KingsStarDV/FABR/CAD/Images/Screenshot 2026-10-20 090226.png

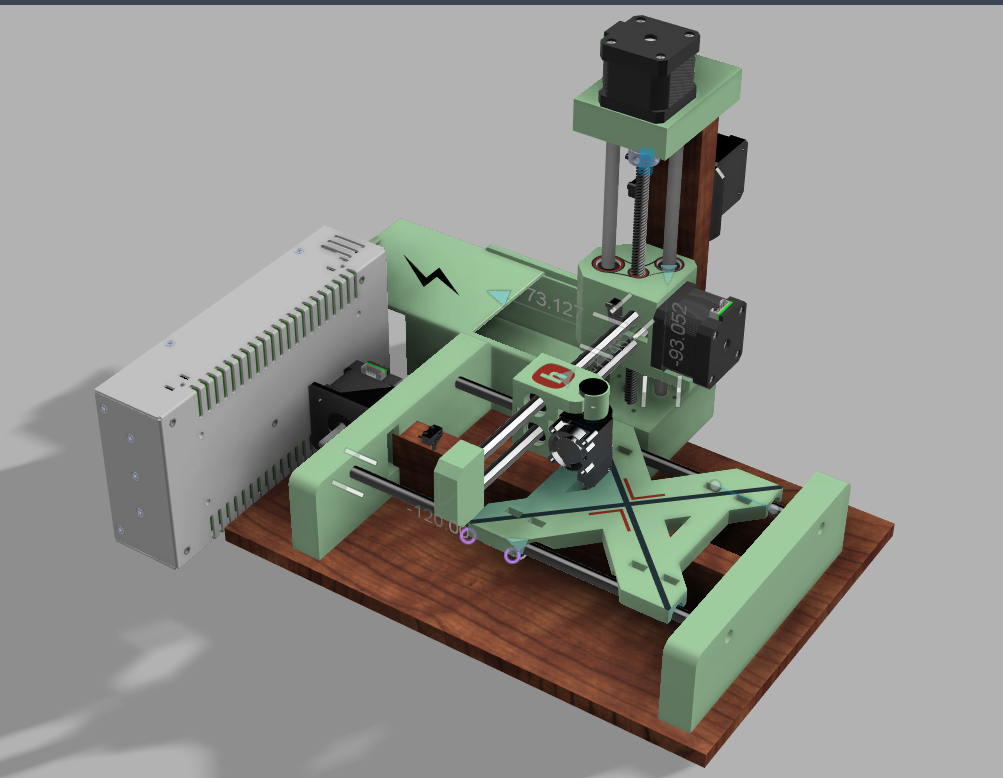
CAD/Images/Screenshot 2026-10-20 090226.png
