KingsStarDV/FABR/ASSET/Raspberry Pi pico/pico-2_view1.jpg

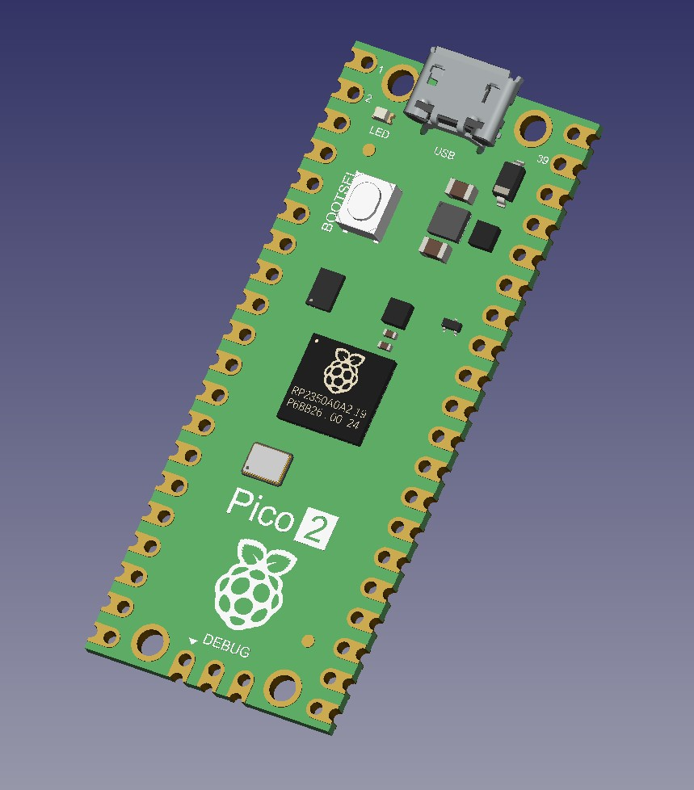
ASSET/Raspberry Pi pico/pico-2_view1.jpg
