KingsStarDV/FABR/ASSET/5mm to 8 mm coupler/[7862] Aluminum Flexible Coupling Coupler Helical Shaft 5mm x 8mm sunrobotics_in.JPG

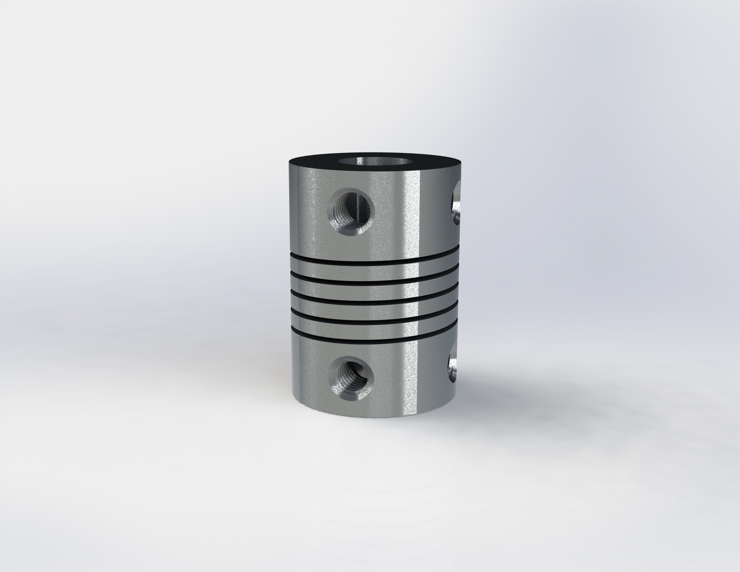
ASSET/5mm to 8 mm coupler/[7862] Aluminum Flexible Coupling Coupler Helical Shaft 5mm x 8mm sunrobotics_in.JPG
