KingsStarDV/FABR/ASSET/8mm lead screw/screw.PNG

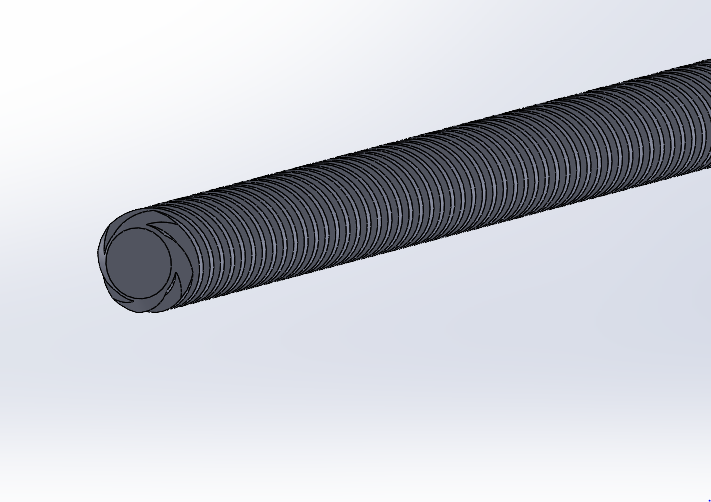
ASSET/8mm lead screw/screw.PNG
