KingsStarDV/FABR/ASSET/8mm_Linear Bearing/linear Bearing 2.png

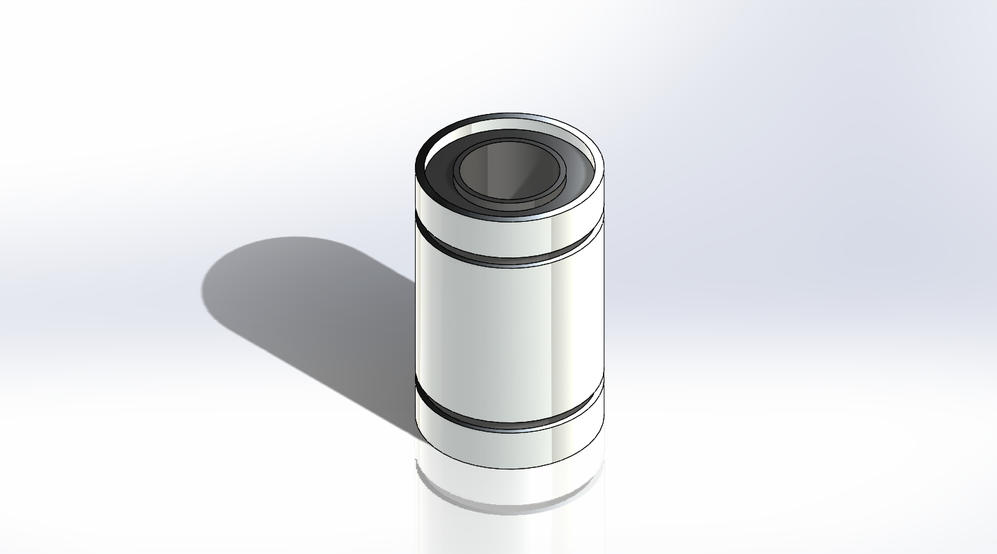
ASSET/8mm_Linear Bearing/linear Bearing 2.png
