KingsStarDV/FABR/ASSET/8mm_Linear Bearing/linear Bearing.png

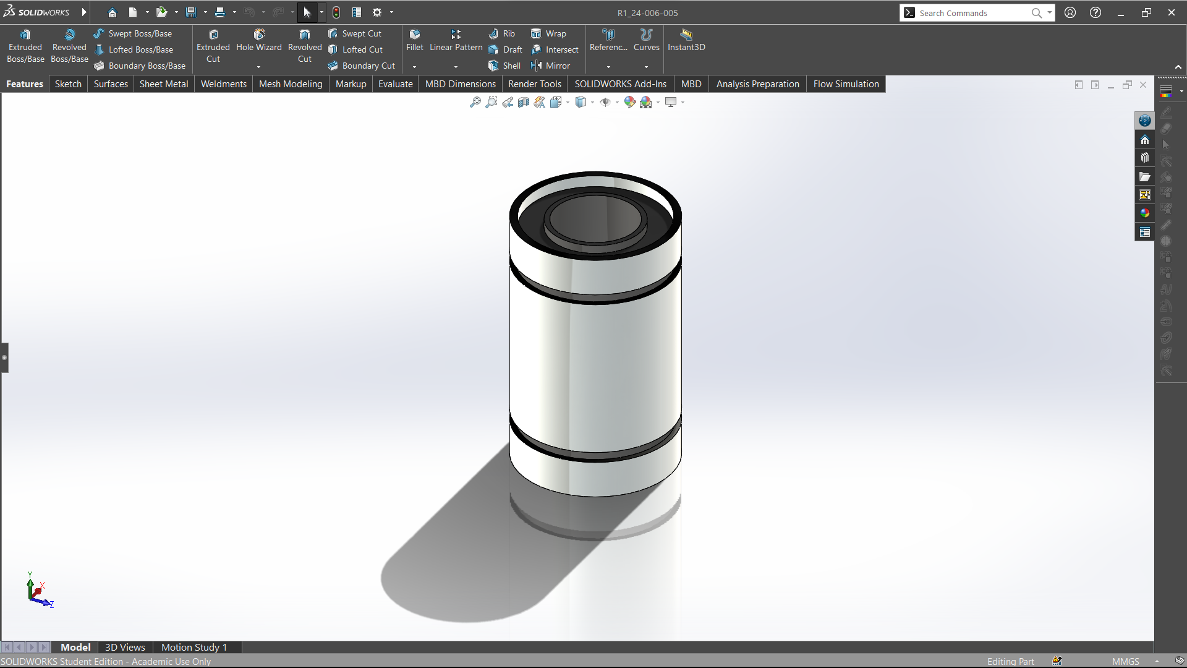
ASSET/8mm_Linear Bearing/linear Bearing.png
