KingsStarDV/FABR/ASSET/Bowden Extruder/Bowden accessory2.png

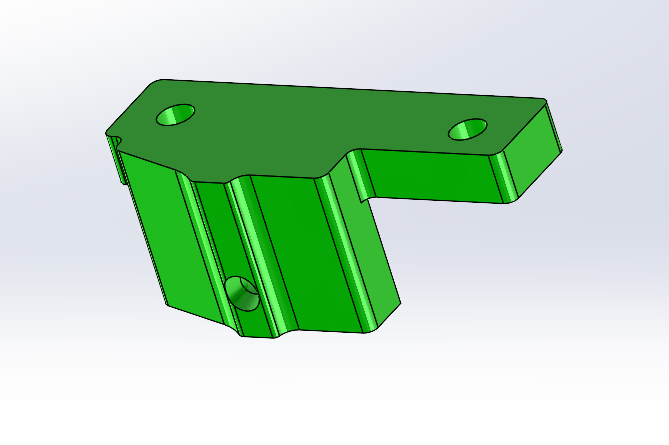
ASSET/Bowden Extruder/Bowden accessory2.png
