KingsStarDV/FABR/ASSET/Bowden Extruder/Bowden accessory3.png

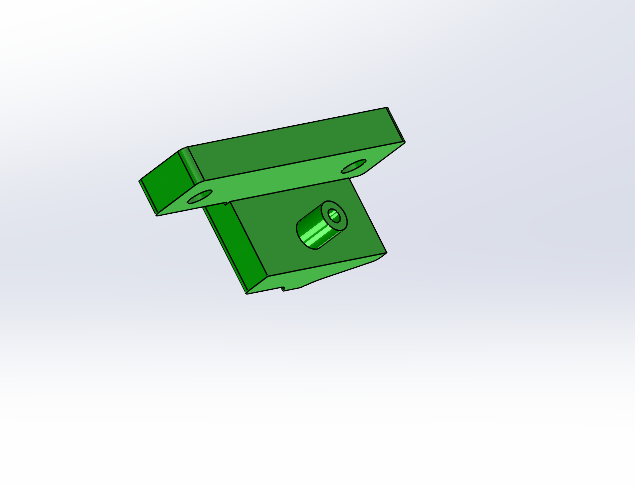
ASSET/Bowden Extruder/Bowden accessory3.png
