KingsStarDV/FABR/ASSET/Bowden Extruder/Bowden accessory.png

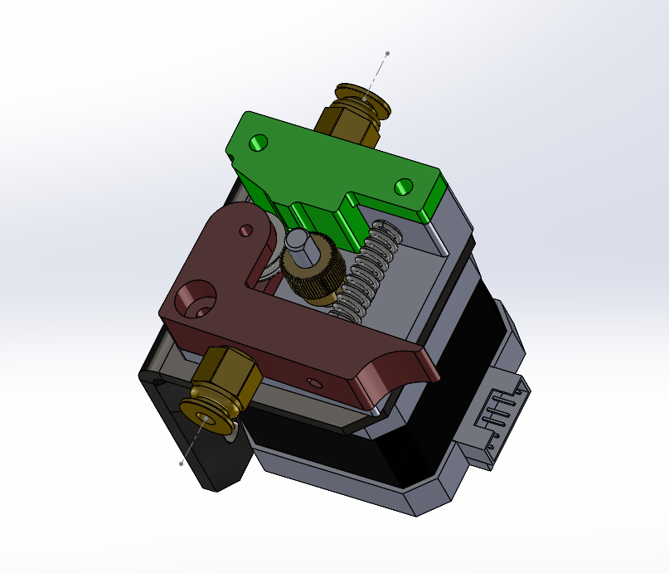
ASSET/Bowden Extruder/Bowden accessory.png
