KingsStarDV/FABR/ASSET/Lead Screw NUT/IMG_7766.jpeg

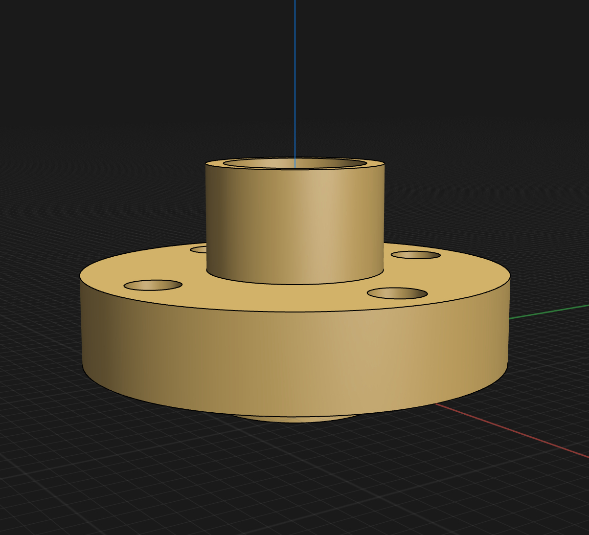
ASSET/Lead Screw NUT/IMG_7766.jpeg
