KingsStarDV/FABR/ASSET/Lead Screw NUT/IMG_7767.jpeg

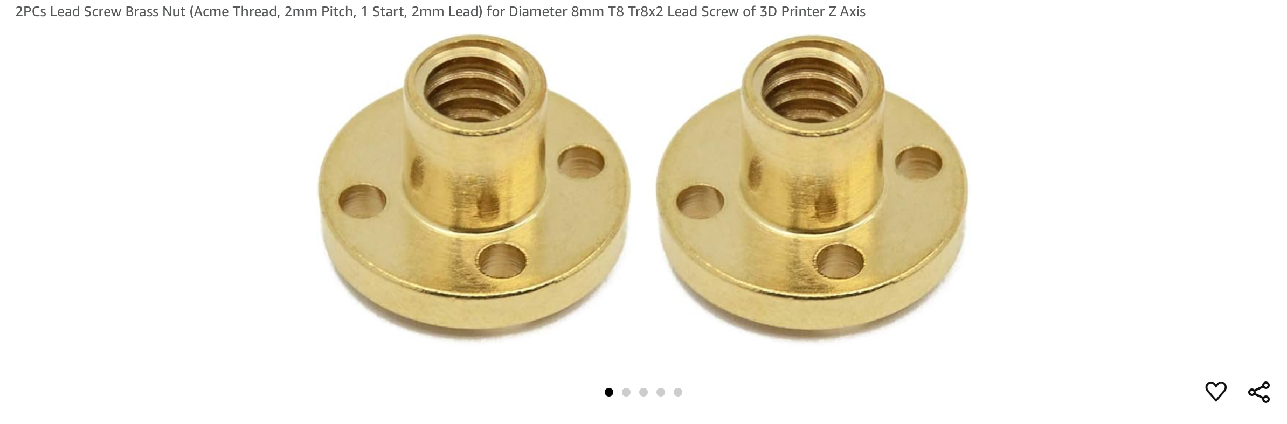
ASSET/Lead Screw NUT/IMG_7767.jpeg
