KingsStarDV/FABR/ASSET/Limit_Switch_L1/Capture.png

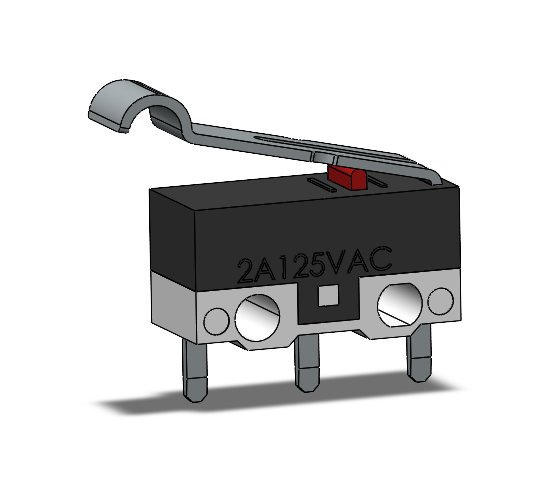
ASSET/Limit_Switch_L1/Capture.png
