KingsStarDV/FABR/ASSET/Raspberry Pi pico/pico-2_view2.jpg

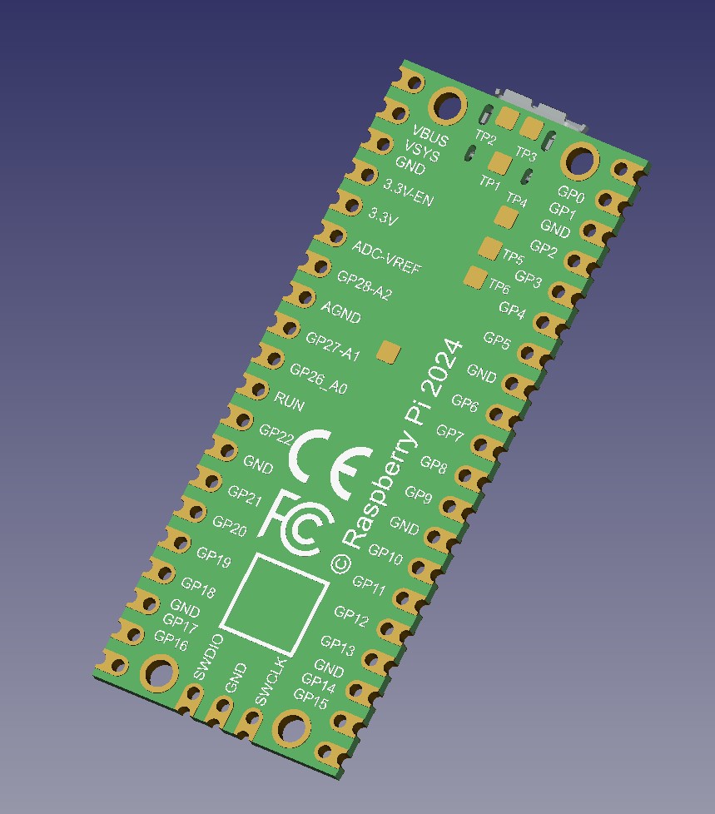
ASSET/Raspberry Pi pico/pico-2_view2.jpg
