KingsStarDV/FABR/ASSET/Raspberry Pi pico/pico-2_view3.jpg

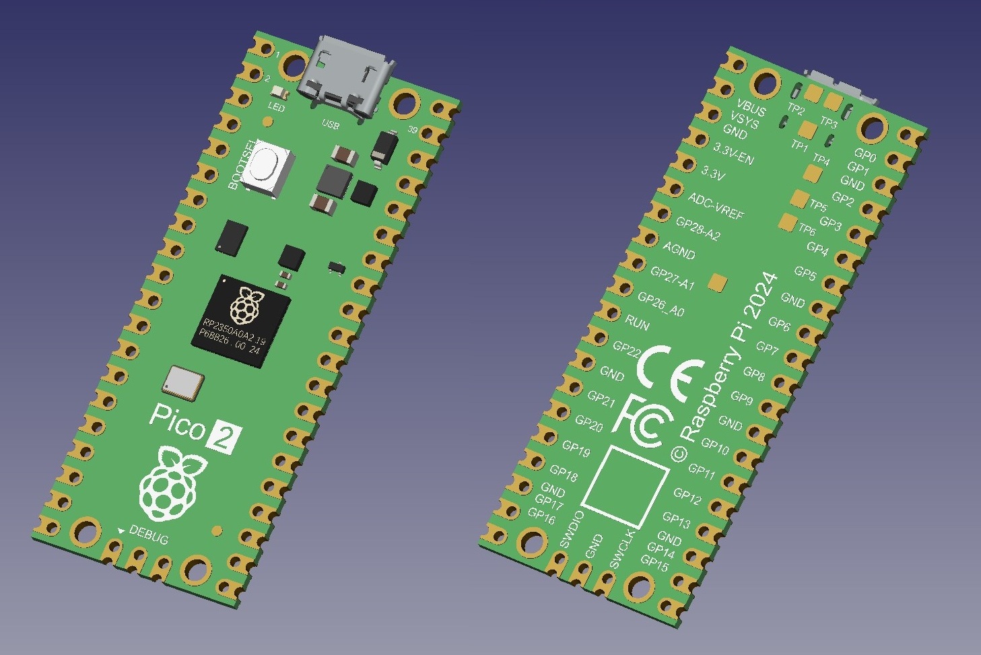
ASSET/Raspberry Pi pico/pico-2_view3.jpg
