KingsStarDV/FABR/ASSET/Raspberry Pi pico/raspberry_pico_size.png

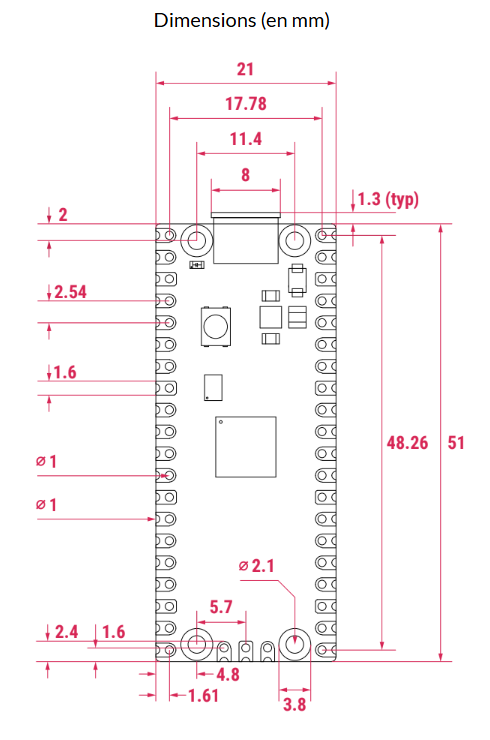
ASSET/Raspberry Pi pico/raspberry_pico_size.png
