KingsStarDV/FABR/ASSET/V6J Hotend/Hotend Volcano J-head V6.PNG

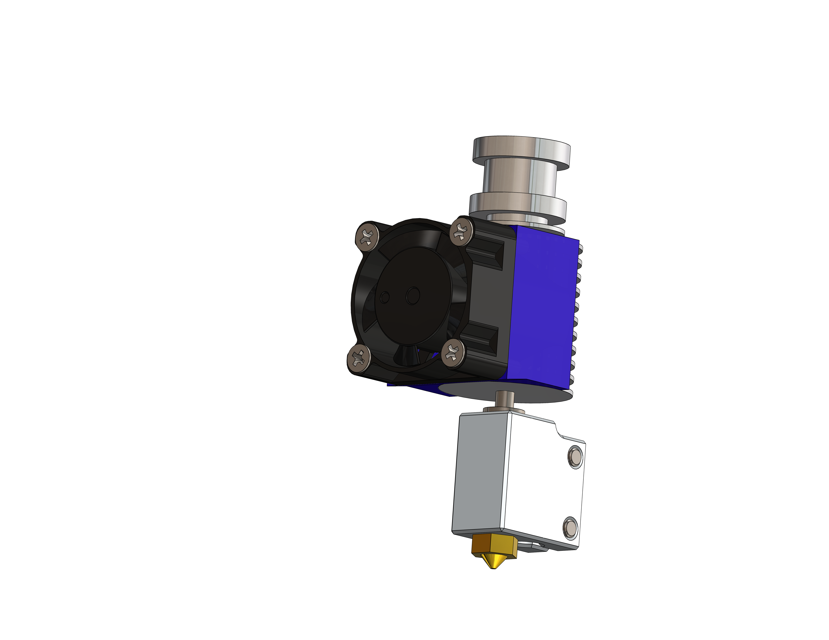
ASSET/V6J Hotend/Hotend Volcano J-head V6.PNG
