KingsStarDV/FABR/Images/325ba0f1-53e9-48e7-aa71-8d3992a2570e.PNG

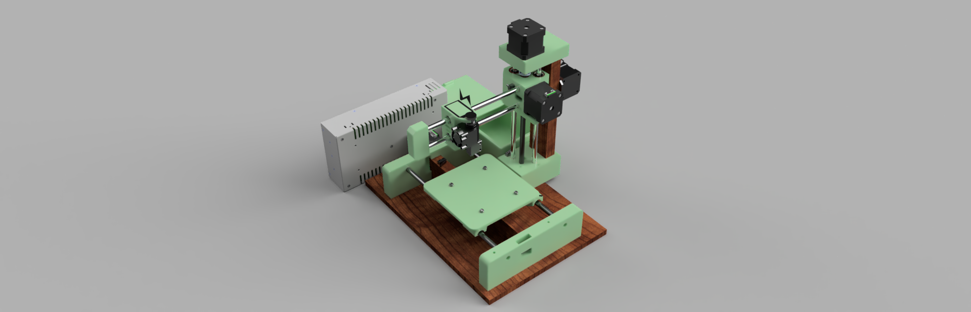
Images/325ba0f1-53e9-48e7-aa71-8d3992a2570e.PNG
