KingsStarDV/FABR/Images/WD1.png

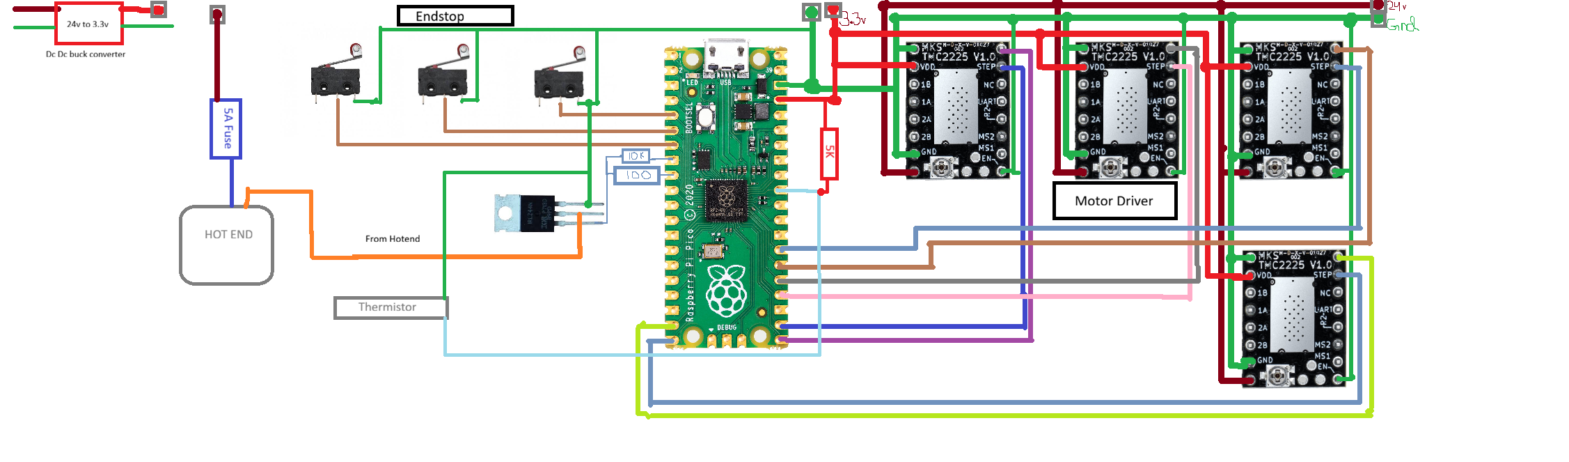
Images/WD1.png
