KingsStarDV/FABR/BOM.csv

Item | Qty | Description | Unit Price ( INR ) | Total Price( INR ) | Total Price (USD) | Link
Raspberry Pi Pico | 1 | Microcontroller | 384 | 384 | 4.608 | https://robu.in/product/raspberry-pi-pico/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
TMC2225 | 4 | Stepper Motor Driver | 400 | 1600 | 19.2 | https://robu.in/product/bigtreetech-tmc2225-v1-0-stepper-motor-driver/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
Nema 17 Motor | 4 | Stepper Motor | 549 | 2196 | 26.352 | https://robocraze.com/products/17hs4401-nema17-stepper-motor-40mm?variant=42490709246176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
Endstop Switch | 3 | Switches for Homing | 23 | 69 | 0.828 | https://robu.in/product/kw4-z5f150-spdt-roller-lever-micro-switch-5a1-5n/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
Irfz44N | 1 | Mosfet for Hotend | 44 | 44 | 0.528 | https://robu.in/product/irlz44n/
V6 J hotend | 1 | hotend | 764 | 764 | 8.404 | https://evelta.com/v6-remote-hotend-with-fan-24v-40w-1-75-0-4mm/?sku=509-B01487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
DC-DC buck converter | 1 | To change 24v to 3.3v for electronic | 135 | 135 | 1.62 | https://robocraze.com/products/lm2596-dc-dc-step-down-buck-module-with-display?_pos=2&_sid=0c32e3ade&_ss=r
4.7K resistor | 8 | Got 8 as they were the MOQ/ replacement as the 5K resistors | 1.3 | 11 | 0.132 | https://robu.in/product/4-7k-ohm-1w-metal-film-resistor-pack-of-40/
100ohm Resistors | 6 | 6 is the MOQ | 1.7 | 11 | 0.132 | https://robu.in/product/1w-100-ohm-resistor-pack-of-40/
5A Fuse | 2 | 2 is MOQ | 9 | 18 | 0.216 | https://robu.in/product/1-month-warranty-1350/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
Smooth Rod (1 meter) | 1 | total length required: 1380mm Will get the part in (1 + 0.4) m | 380 | 380 | 4.56 | https://onlyscrews.in/products/8mm-smooth-rod-stainless-steel-304-1meter-1000mm
Smooth Rod (0.4m) | 1 | --------- | 179 | 179 | 2.148 | https://robu.in/product/400-mm-long-chrome-plated-smooth-rod-diameter-8-mm/
LM8UU | 10 | Linear bearing (8mm) | 49 | 490 | 5.88 | https://robocraze.com/products/lm8uu-8-mm-linear-motion-bearing-for-3d-printer?variant=40193531052185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
MK8 Bowden Extruder Kit | 1 | this includes all parts required to make a extruder | 199 | 199 | 2.388 | https://robocraze.com/products/extruder-kit-left-side-mk8-aluminum-3d-printer-block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
Nema 17 Mount | 2 | mount for stepper motor | 202 | 404 | 4.848 | https://robu.in/product/easymech-bracket-for-nema-17-stepper-motor/
Lead Screw (300mm) + Nut | 1 | -----nearest i could find to 240mm is 300mm | 249 | 249 | 2.988 | https://robocraze.com/products/trapezoidal-screw-300mm-rod-with-copper-nut?_pos=5&_sid=3191a7e76&_ss=r
5mm to 8mm shaft coupler | 1 | to join lead screw and nema17 shaft | 105 | 105 | 1.26 | https://robu.in/product/nema-17-shaft-coupling-coupler-shaft-5mm-x-8mm/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
GT2 6mm pulley | 2 | ---------- | 45 | 90 | 1.08 | https://robocraze.com/products/gt2-6mm-belt-width-20-teeth-5mm-bore-timing-pulley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
GT6 6mm Timing Belt(1m) | 1 | needed:90cm | 90 | 90 | 1.08 | https://robocraze.com/products/1-meter-x-gt2-open-timing-belt-6mm-width-pitch-2mm-for-3d-printer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
Zip ties | 50 | to hold together timing belts, and fix bed plate with linear bearings | 0.4 | 20 | 0.24 | https://onlyscrews.in/products/2-5mm-x-100mm-white-color-multi-purpose-self-locking-nylon-industrial-grade-cable-zip-tie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
M4 Screws | 10 | ----- | 2.8 | 28 | 0.336 | https://onlyscrews.in/products/chhd-m4-x-20mm-pack-of-20
M1.6 Screws | 4 | -------- | 6 | 24 | 0.288 | https://onlyscrews.in/products/m1-6-x-8mm-hex-allen-socket-head-ss-304-screw-dia-1-6mm-length-8mm
M4 60mm Screw | 5 | -----For the Rod holders-- | 13 | 65 | 0.78 | https://onlyscrews.in/products/m4-x-60mm-hex-allen-csk-high-tensile10-9-black-oxide-screw-dia-4mm-length-60mm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
M3 8mm | 14 | ---for stepper motor | 1.2 | 16.8 | 0.2016 | https://onlyscrews.in/products/m3-x-6mm-phillips-csk-ss-304-screw-dia-3mm-length-6mm
M3 10mm | 4 | ----for vertical support and custom mount | 1.6 | 6.4 | 0.0768 | https://onlyscrews.in/products/phillips-csk-m3-x-10mm-pack-of-20
M2 Screws | 8 | --------- | 2.6 | 20.8 | 0.2496 | https://onlyscrews.in/products/m2-x-5mm-hex-allen-socket-head-ss-304-screw-dia-2mm-length-5mm
3.5mm Self Tapping Screw | 4 | ---for extruder and bottom y axis part. | 1.6 | 6.4 | 0.0768 | https://onlyscrews.in/products/no-63-5mm-x-13mm-phillips-csk-ss-304-self-tapping-wood-screw
Compression Spring | 4 | -----for bed assembly | 6 | 24 | 0.288 | https://onlyscrews.in/products/od-6mm-free-length-15mm-wire-dia-0-8mm-compression-spring-stainless-steel-304
M4 20mm Screw | 4 | -----for bed assembly | 3.2 | 12.8 | 0.1536 | https://onlyscrews.in/products/m4-x-20mm-hex-bolt-ss304-dia-4mm-length-20mm
M4 Hex Nut | 4 | ----for bed assembly | 1.6 | 6.4 | 0.0768 | https://onlyscrews.in/products/m4-nylon-hex-nut-dia-4mm
Wire (3m) | 3 | for connections of endstop switches and motor drivers | 45 | 135 | 2.7 | https://robocraze.com/products/ribbon-cable-10-wire-1-meter?_pos=1&_sid=4ef974617&_ss=r
4 pin JST connector | 4 | for connecting stepper motor | 50 | 200 | 2.4 | https://robu.in/product/720mm-cable-with-connector-for-nema17-stepper-motor/
24v SMPS | 1 | ----------Already have it | -- | -- | 0 | --
1 Kg PETG Filament | 1 | -------For printing legion | 1000 | 1000 | 12 | https://robocraze.com/products/anycubic-petg-black-1kg-1-75mm-petg-3d-printer-filament?variant=67651507224800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
 |  |  | Total Shipping Costs (INR) : | 149
 |  |  | Total Cost (USD): | 108.1192
