KingsStarDV/FABR/ASSET/5mm to 8 mm coupler/[7862] Aluminum Flexible Coupling Coupler Helical Shaft 5mm x 8mm sunrobotics_in.STEP

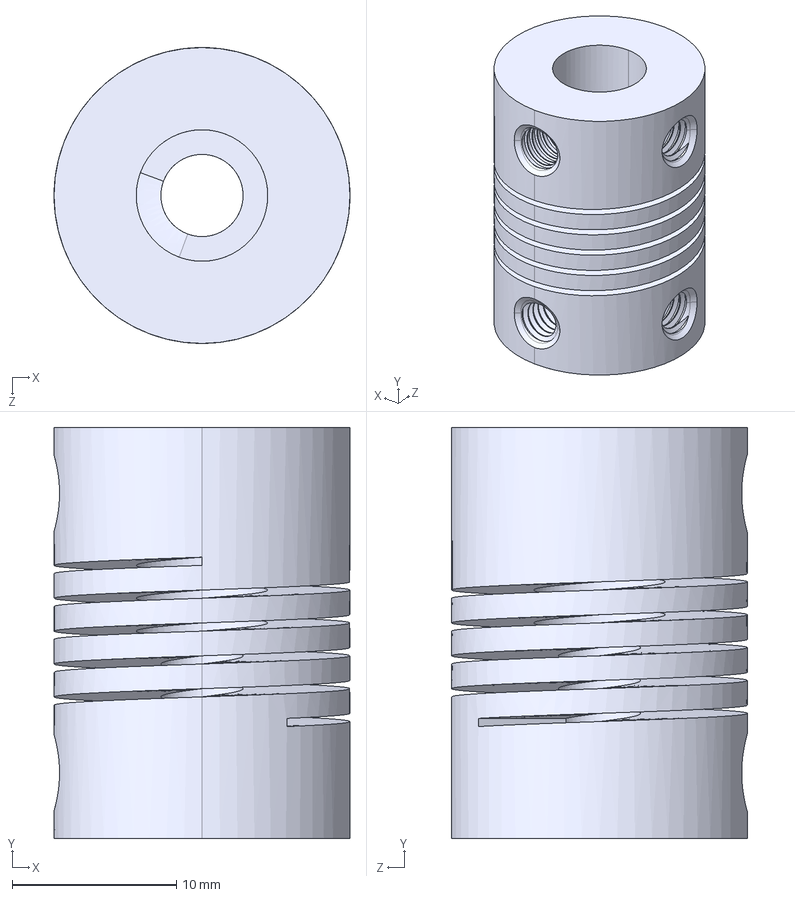
[picture p20: CAD file, 2026-10-20]
ASSET/5mm to 8 mm coupler/[7862] Aluminum Flexible Coupling Coupler Helical Shaft 5mm x 8mm sunrobotics_in.STEP
18.0 x 25.0 x 18.0 mm
