KingsStarDV/FABR/ASSET/8mm_Linear Bearing/R1_24-006-005.SLDPRT

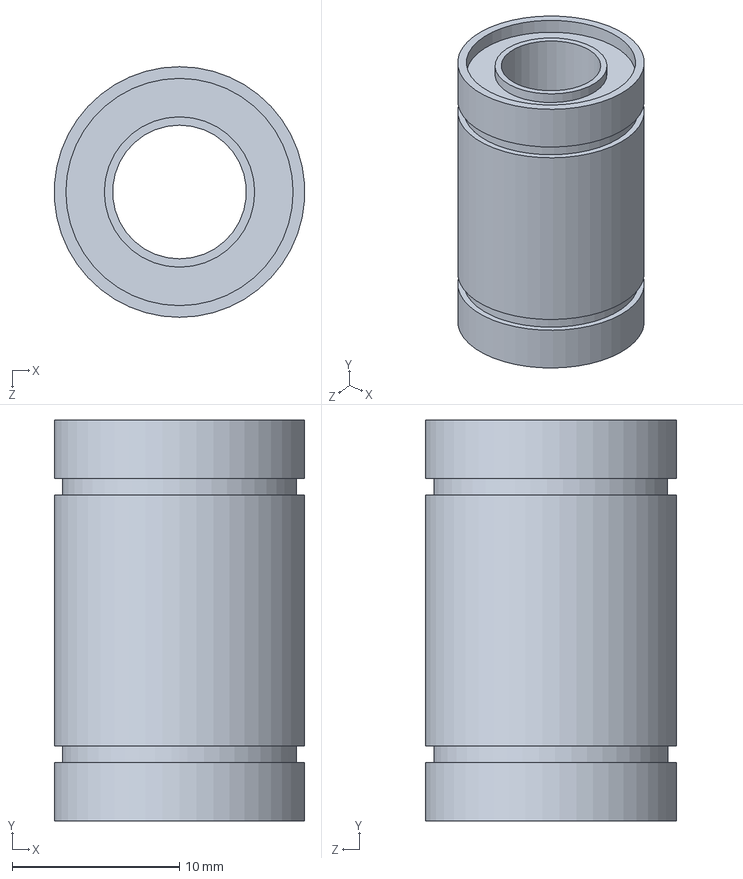
[picture p21: CAD file, 2026-10-20]
ASSET/8mm_Linear Bearing/R1_24-006-005.SLDPRT
15.0 x 24.0 x 15.0 mm
