KingsStarDV/FABR/ASSET/Bowden Extruder/step file.STEP

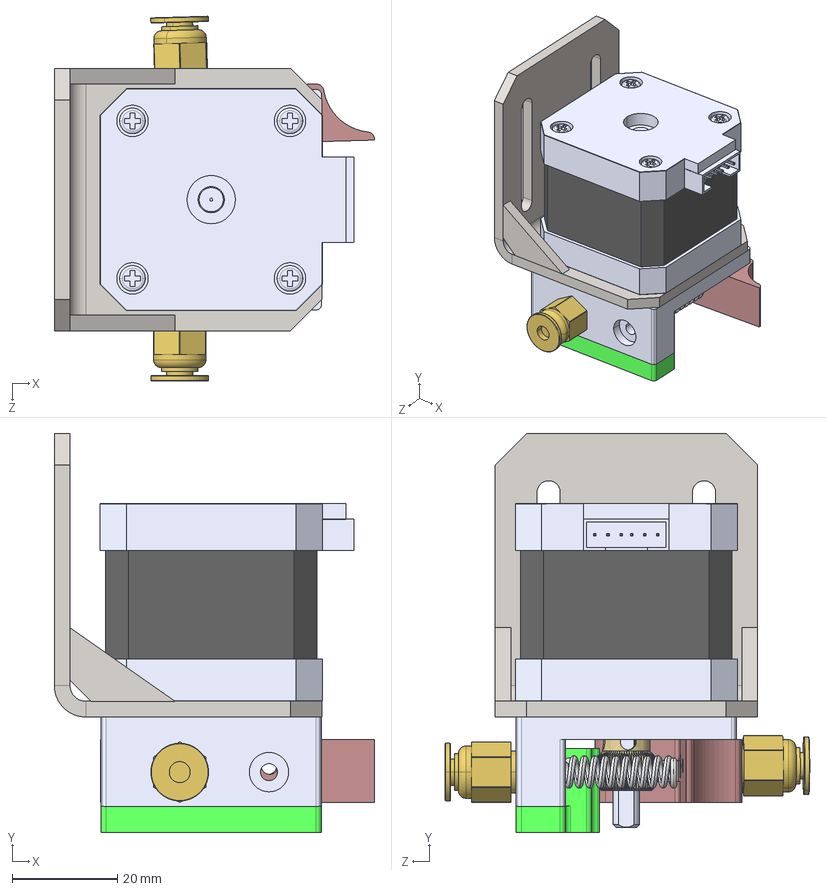
[picture p22: CAD file, 2026-10-20]
ASSET/Bowden Extruder/step file.STEP
61.0 x 76.0 x 69.4 mm
Base stepper engine_Predeterminado
flamula_Predeterminado x 2
NEMA17 Stepper_Predeterminado
Part1 left_Predeterminado
Part12 left_Predeterminado
idler bearing_Predeterminado
trac_Predeterminado
Bowden_Predeterminado x 2
mola_Predeterminado
calço_Predeterminado
