KingsStarDV/FABR/ASSET/Limit_Switch_L1/Limit_Switch_L1.STEP

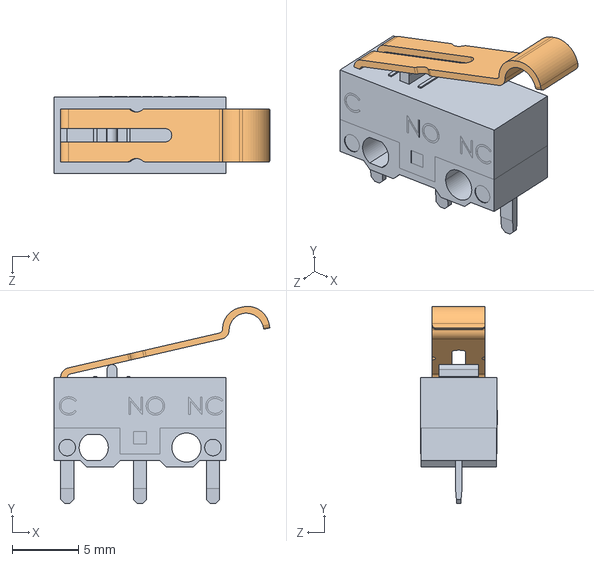
[picture p23: CAD file, 2026-10-20]
ASSET/Limit_Switch_L1/Limit_Switch_L1.STEP
16.3 x 14.9 x 5.81 mm
