KingsStarDV/FABR/ASSET/nema 17-Holder/nema 17 holder.SLDPRT

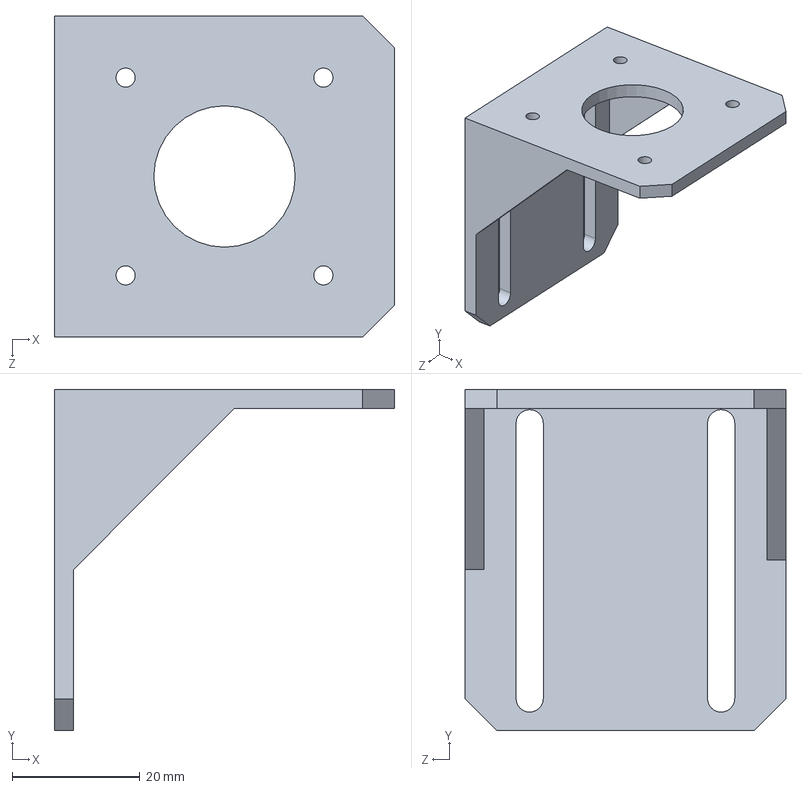
[picture p24: CAD file, 2026-10-20]
ASSET/nema 17-Holder/nema 17 holder.SLDPRT
53.3 x 53.5 x 50.3 mm
