KingsStarDV/FABR/ASSET/TMC2208/TMC2208-or-9-Socketed.step

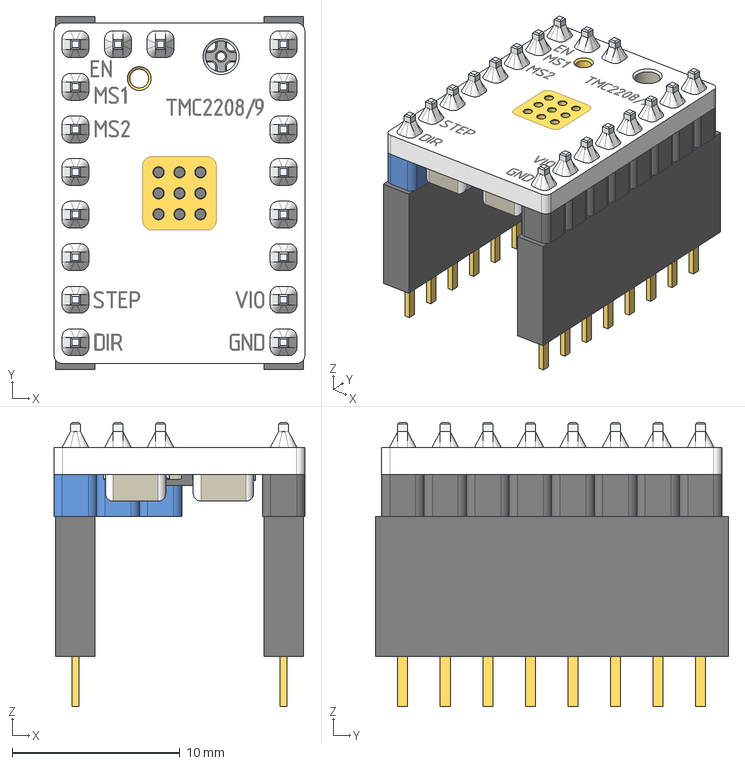
[picture p25: CAD file, 2026-10-20]
ASSET/TMC2208/TMC2208-or-9-Socketed.step
15.0 x 21.1 x 16.9 mm
