KingsStarDV/FABR/ASSET/V6J Hotend/Hotend Volcano J-head V6.STEP

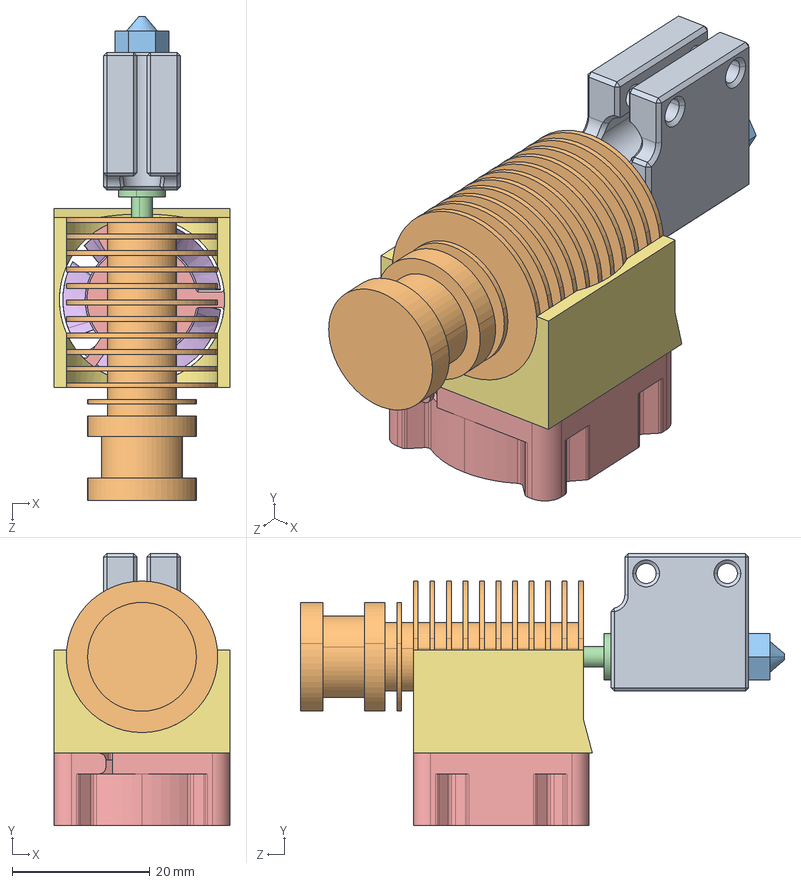
[picture p26: CAD file, 2026-10-20]
ASSET/V6J Hotend/Hotend Volcano J-head V6.STEP
25.5 x 39.5 x 70.3 mm
Bloco Aquecedor
Dissipador
Bico 0.4mm
Tubo conector
Body.step
Blades.step
Acoplador da ventoinha
