KingsStarDV/FABR/CAD/FABR(STP).step

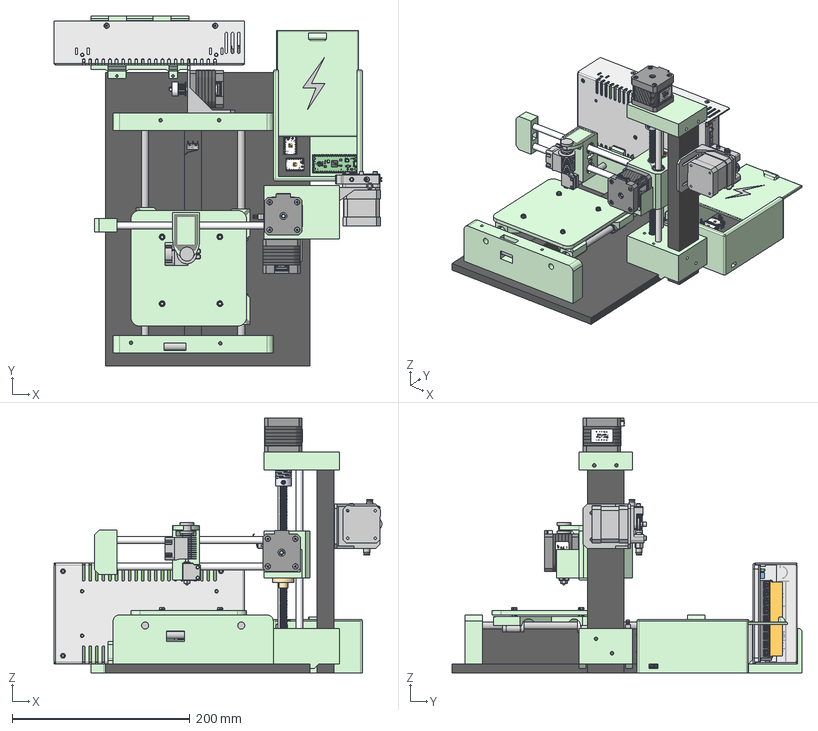
[picture p27: CAD file, 2026-10-28]
CAD/FABR(STP).step
368.3 x 393.3 x 286.0 mm
