KingsStarDV/FABR/CAD/STL/Y Axis Base.stl

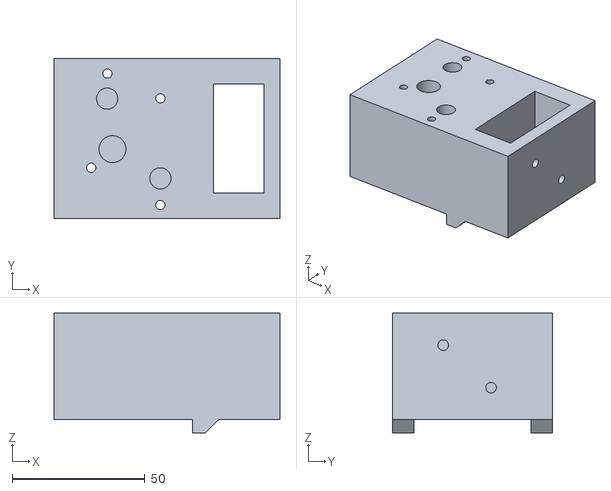
[picture p28: CAD file, 2026-10-28]
CAD/STL/Y Axis Base.stl
85.0 x 60.0 x 45.0
