KingsStarDV/FABR/ASSET/TMC2208/TMC2208-or-9-UncutPins.step

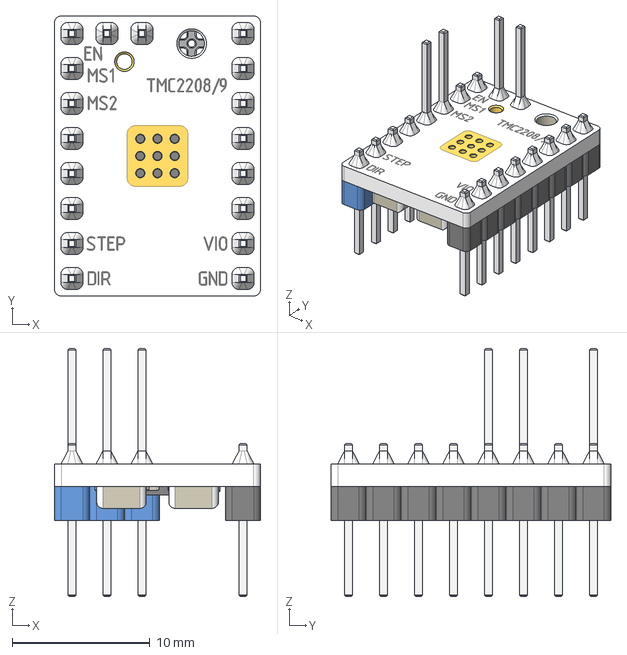
[picture p29: CAD file, 2026-10-20]
ASSET/TMC2208/TMC2208-or-9-UncutPins.step
15.0 x 20.3 x 18.0 mm
