KingsStarDV/FABR/ASSET/V6J Hotend/Acoplador da ventoinha.SLDPRT

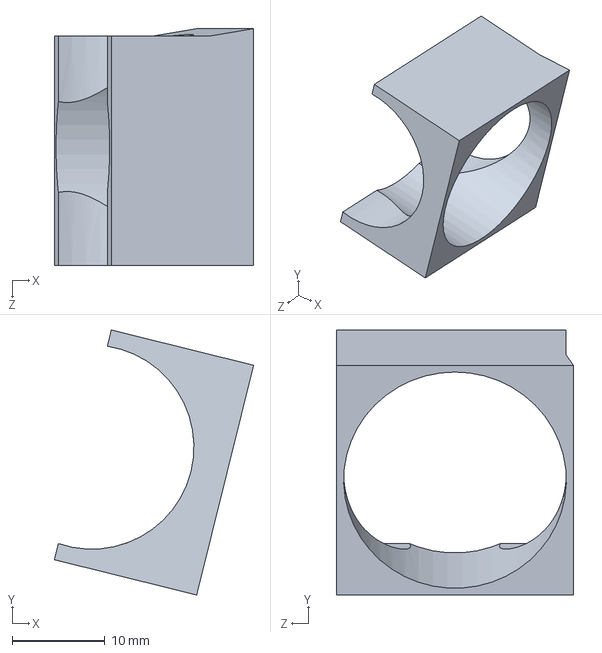
[picture p30: CAD file, 2026-10-20]
ASSET/V6J Hotend/Acoplador da ventoinha.SLDPRT
21.5 x 28.6 x 25.5 mm
