KingsStarDV/FABR/CAD/STL/Z axis end.stl

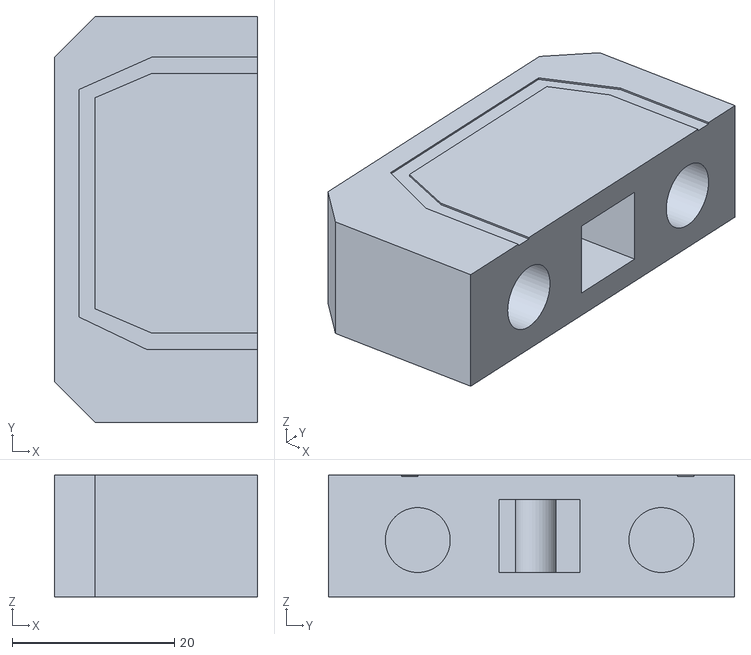
[picture p31: CAD file, 2026-10-26]
CAD/STL/Z axis end.stl
25.0 x 50.0 x 15.0
