KingsStarDV/FABR/ASSET/TMC2208/TMC2208-or-9-CutPins.step

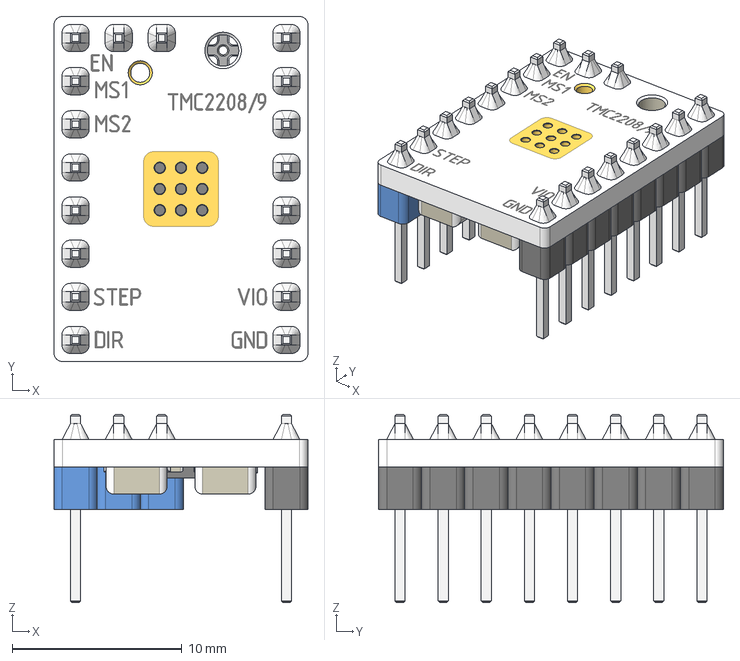
[picture p32: CAD file, 2026-10-20]
ASSET/TMC2208/TMC2208-or-9-CutPins.step
15.0 x 20.3 x 11.1 mm
