KingsStarDV/FABR/CAD/STL/Custom Stepper Mount.stl

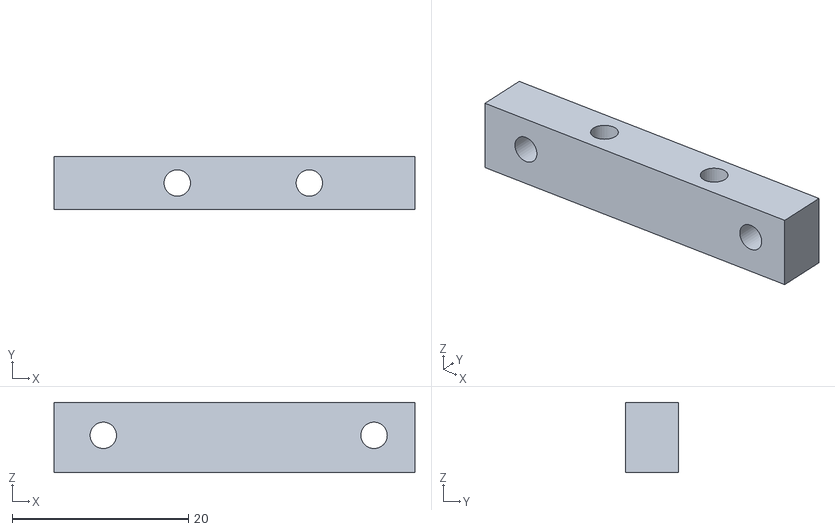
[picture p33: CAD file, 2026-10-26]
CAD/STL/Custom Stepper Mount.stl
41.0 x 6.00 x 8.00
