KingsStarDV/FABR/CAD/STL/Y Axis Top.stl

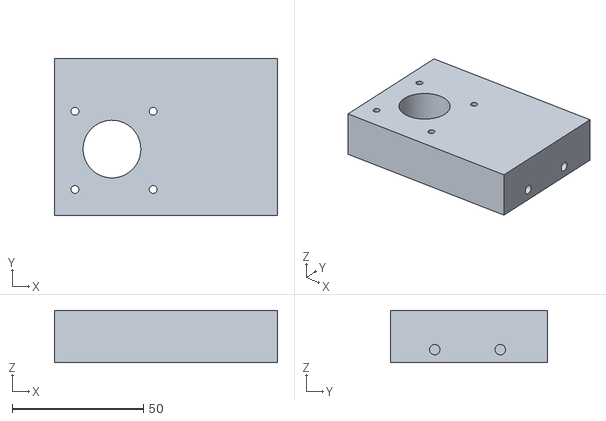
[picture p34: CAD file, 2026-10-26]
CAD/STL/Y Axis Top.stl
85.0 x 60.0 x 20.0
