KingsStarDV/FABR/CAD/STL/Z Moving Part.stl

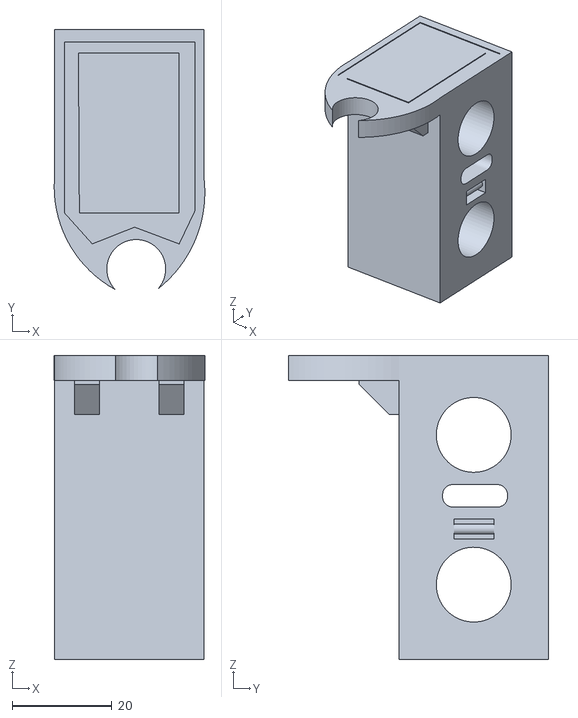
[picture p35: CAD file, 2026-10-26]
CAD/STL/Z Moving Part.stl
30.2 x 52.1 x 60.9
