KingsStarDV/FABR/CAD/STL/Y_Moving Part.stl

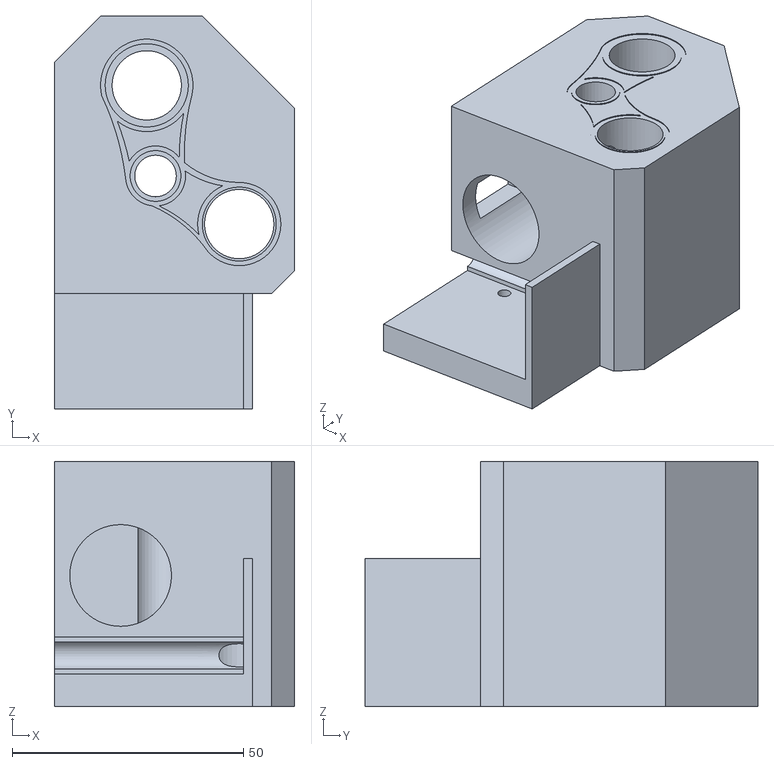
[picture p36: CAD file, 2026-10-26]
CAD/STL/Y_Moving Part.stl
52.0 x 85.0 x 53.0
