KingsStarDV/FABR/CAD/STL/Front Rod Holder.stl

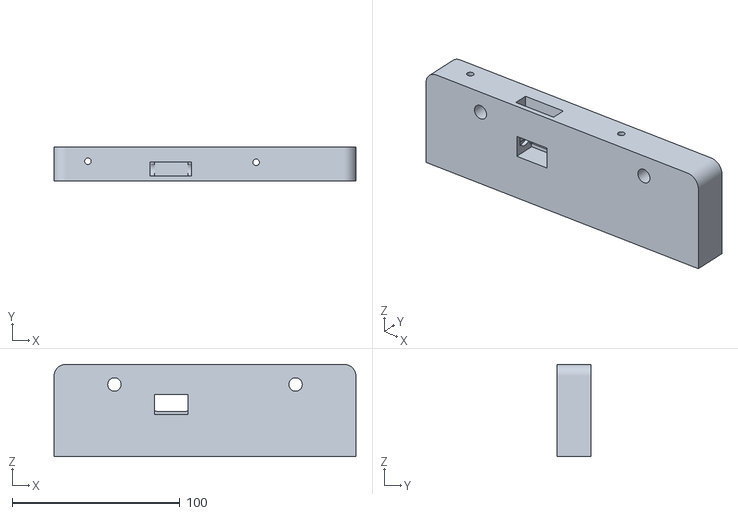
[picture p37: CAD file, 2026-10-22]
CAD/STL/Front Rod Holder.stl
180.0 x 20.0 x 55.0
