KingsStarDV/FABR/CAD/STL/Moving Bed .stl

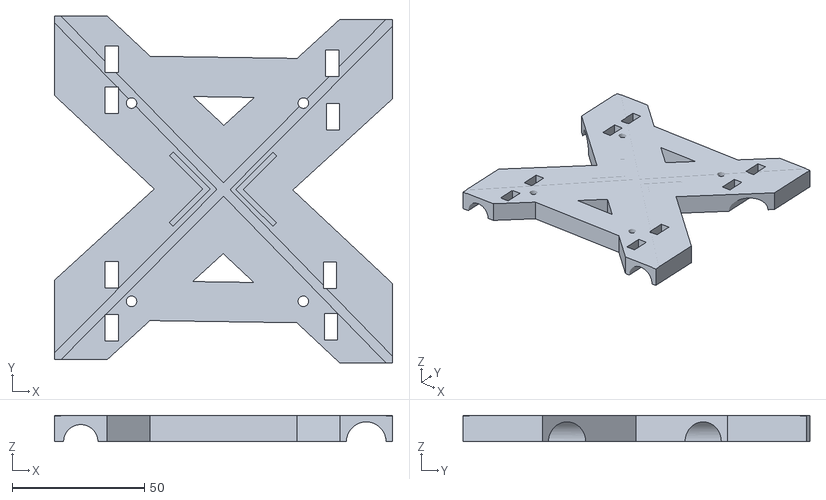
[picture p38: CAD file, 2026-10-22]
CAD/STL/Moving Bed .stl
128.0 x 131.3 x 10.0
