KingsStarDV/FABR/CAD/STL/Rod Holder (Back Part).stl

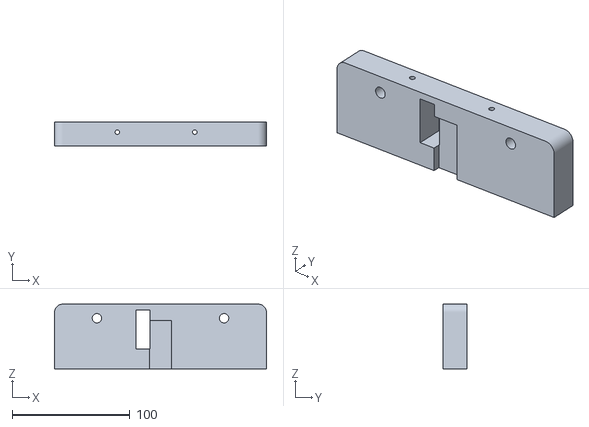
[picture p39: CAD file, 2026-10-22]
CAD/STL/Rod Holder (Back Part).stl
180.0 x 20.0 x 55.0
