KingsStarDV/FABR/CAD/STL/Hotend Holder.stl

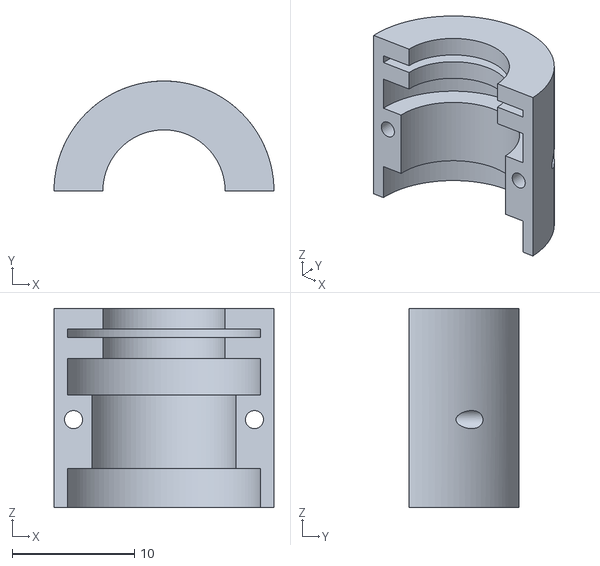
[picture p40: CAD file, 2026-10-20]
CAD/STL/Hotend Holder.stl
18.0 x 9.00 x 16.3
