KingsStarDV/FABR/(list of files, cad)

Other CAD files:
ASSET/8mm_Linear Bearing/linear bearing 3.STEP
ASSET/Bowden Extruder/IGS file.IGS
ASSET/8mm lead screw/lead screw 8mm.SLDPRT
ASSET/Bowden Extruder/rhno6 file.3dm
ASSET/Limit_Switch_L1/Limit_Switch_L1.SLDPRT
ASSET/V6J Hotend/Hotend Volcano J-head V6.SLDASM
CAD/Assembly.f3z
CAD/FABR (assembled).f3z
CAD/FABR(Assembled).f3z
