KingsStarDV/FABR/Images/Assembly Render.jpg

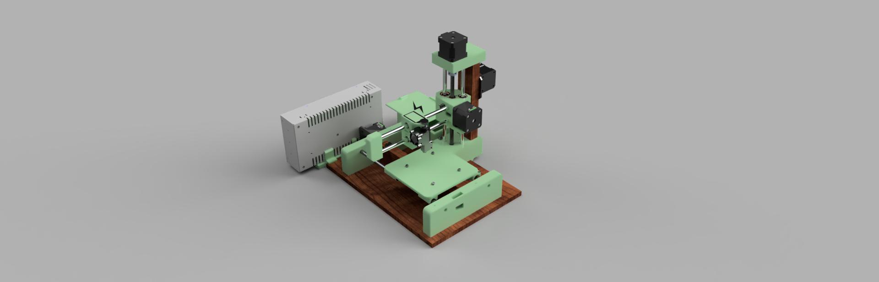
Images/Assembly Render.jpg
