KingsStarDV/FABR/JOURNAL.md

---
title: "FABR v1"
github: "https://github.com/KingsStarDV/FABR"
description: "FABR: Filament Added Builder and Replicator"
created_at: "2026-10-04"
total_time: "35h"
---

# October 10, 2026: made basic idea
<!-- fabricate:entry 318 -->

so, not much.
today i open fusion after many mnay days, so took a bit of time to get refamiliar with the controlls and everything.
but apart from that i made the basic idea of what my 3d printer would look like.

i m thinking to make it a small printer.

not much.. it is a cartesian printer, utilising normal NEMA 17 motor and lead screw and pulley.

i also made a video of the joints of the printer, but the journal would not allow me to upload videos.
thats all



**Total time spent: 1h**

# October 11, 2026: CAD designed the base
<!-- fabricate:entry 344 -->

started with making the base.
i was thinking of a 200x200 print area.

for that I made the base design as -


It looked nice. Until i realised that the height of the model was very short, in order to fit a nema 17 motor in there.
also, there was no space inside, to attach the stepper motor for moving the gantry plate.


the holes made, are for the smooth rod to slide in.
[If u have no idea about smooth rod- they are basically just 'smooth' steel rods and their purpose is to allow a gantry plate attached to them via a linear ball bearings to move smoothly.]

this looked okay.
so i proceeded with making attaching brackets for the motor.


I made this on one of the end, the motor will be glued to this place.
Now u may ask, why glued to it not screwed in.
the reason being that the complete base plate in to be printed in one single part. and to save on cost, it will be made in around 30-40% infill but, if the mounting bracket only has that low infill (of 30-40%) the screws might not keep in place and overtime create a larger hole.
next, i added a nema 17, to check if it fits. and guess what ? IT DOES.!


my last job was to make a idler pulley bracket on the other side.



**Total time spent: 2h 30m**

# October 13, 2026: Major Design Changes
<!-- fabricate:entry 385 -->

so, i just realised something..

The design i was going for was a completely 3D printed design.
I was hoping that to reduce effort to building.

However, I didn't accounted for 3D printing cost back then.
**## Now that i have realised it, i wan to change my design due to multiple reasons-**

> COST: The 3D printed base, Frame, and the parts that i would have designed in future, would all add to very high costs.
> Strength: 3D printed parts are really strong. But they come nowhere close the strength of material like wood. In my new design i have decided to use wood as the structural support material.\

 Now there were the most important reasons..

Then I proceeded on to create the design CAD models.
The BASIC idea of the printer would be the same. 

I then made the design for the front plate of the base frame. (front and back plate would be shown in CAD model along with the rest parts for clarity in upcoming journals.)



Now, the rectangular groove in the between is where the wood piece would fit and would be glued.

And the 2 holes are for the smooth rods.
..

The basic design of the backplate was similar to the front plate.
Now, i added a stepper motor mount into the CAD model, and took measurements for screws to be in place.


this is where the screws would be screws in along with the stepper motor mount. _**[more on how will these plates be held together later]**_
..
.

This is how the back plate looks like along with the motor mount.


Finally i removed ome part from the back plate to make place for the timing belt to pass through.



**Total time spent: 2h**

# October 14, 2026: CAD Modeling The Y axis.
<!-- fabricate:entry 403 -->

so, I did some progress on the project.

- First: I assembled the base of the printer.
    As i have already told, that this new design would use wood. I also decided to give the right appearance to wood by using the appearance feature of FUSION.
I also made the 3d models of smooth rods [which were nothing, just long cyclinders of 8mm diameter]

These smooth rods are the linear guide system for this project.
They will allow the linear movement of parts. After modelling them, i added a aluminium shiny texture to them.

Nxt i finally assembled the printer base-



Now, this image should have cleared all doubts regarding the motor and its positioning that I reffered to in the previous journal.

Then it was the time to create the y axis movement system.
I was trying very hard to find any other way of doing this part rather than using a big wood piece in the bottom to create space for additional parts.
But i couldnt find any solution.
SO, i had to do it. I added a wood piece in the bottom of the build.
The electronics and y axis would share this part.


Next i moved to create Y axis part.
I started by making a base part for Y axis .


Now, this part is supporting the complete y and z axis, so it must be strong.
This part specifically will be printed in high infill.
Also then i added holes for screws. [the holes are 3.5mm, but M4 screw will be used to screw them in.]



Then i proceded to make the top part of the y axis.


however, this part i designed wrong.
I realised this at the point when i went to assembled the part.

[Continue to the next journal.]-(Picture limit reached here)

**Total time spent: 3h 30m**

# October 14, 2026 (entry 2): Continuing the Design
<!-- fabricate:entry 404 -->

The problem was that i took the measurement of the holes for the smooth rods wrong.
So i corrected it.


Here is how it looks like in the assembly-

...

Now was the time to add place for the stepper motor in  the y axis..
SInce there is no space left in the bottom, i decided to add the stepper motor on the top.

For that i made a hole in the top part of y axis.
now this part specifically doesnt need much strength, so this will be a low infill part. hence, instead of using screws to hold stepper motor in place, i decided to go with either super glue or hotglue.
The motor also, doesnt experience any real torque, hence even hot glue would work here.


the next step was simple.. i just added a threaded rod on the stepper motor on the top part along with a coupler.
and then made a hole in the bottom part for the threaded rod.



**Thats all for Now.!!**

**Total time spent: 6m**

# October 14, 2026 (entry 3): Y Axis Design
<!-- fabricate:entry 406 -->

i worked on Y axis this time.

_**[BTW, rn my goal is only to make a fully working design and i m no focusing on optimising it in any way.
The optimisation of design is the next step in my mind.]**__

The aim of this next part will be to carry a stepper motor, hotend, extruder motor and a fan.

As per the position of the rods, i first designed a block shaped part with only linear bearings inside to slide onto the smooth rods.



however, there also must be a place to attach a stepper motor so the the Z axis can move.
So, i removed a circular parts for the motor to fit in.


I also made some space in the front face of the part so that timing belt could be accessed.


Then I noticed that there is no place in this part to add any screws.
Due to that reason, i decided to go with glueing again.
but also made a bracket for the motor to sit into.


To finish off this part, i removed some extra material from it in order to save on filament and weight.



Then i proceeded to make the part for the other end of the Z axis.

It was way simpler than the previous part.
Its just a cuboidal block with two circular parts removed for smooth rods to slide in and a rectangular block removed for the timing belt.
the inner part contains of a cylindrical shape which would act as idler pulley for the timing belt.



there are some reasons why i didnt used a real idler pulley with bearing here.
1. To save on cost
2. Make the building easier
3. This axis works on very low speeds and hence, the part would be just fine instead of a Pulley.

**Total time spent: 2h**

# October 15, 2026: Z axis Moving Part Design
<!-- fabricate:entry 489 -->

I again did a long session and finally completed the design for he Z axis.
This axis had way more tinkering than any other axis in the build.

I first started with trying to add the trapezoidal nut for the lead screw.
But then i realised something .
I HAD LEFT NO SPACE FOR THE NUT TO FITTT!!!!!

Now that was problem.
so i had to redo the design of not just the moving y axis part but also the top and bottom y axis parts>...
This was the time when i thought to myself that mybe i should have used parameters and variables to keep everything organised..
I pushed through and completed the redesign anyways.



Next i proceeded to make attachments and support for the hotend.
First i downloaded the CAD file for the hotend from GRABCAD and next took its measurements and made a bracket support for it.-


However when i tried to attach it the the hotend, it was fit.

SO i had to retook measurements and designed again.
(Well, it was just changing the length and radius of the circle inside the part)

Then it fitted.


I also made 2 holes for M1.4 screws.
Finally i mounted everything on the Z moving part and made some cuts in the part for timing belt to pass through.
And then it was complete.



**Total time spent: 2h 54m**

# October 16, 2026: Designing Bed Gantry
<!-- fabricate:entry 508 -->

today i woke up with the idea to make the bed gantry plate in mind.
...

My initial idea was to make it out of wood, but honestly i thought it is boring.

SO i started to research for designs online..
Found some designs but at last i decided to make my own,.

I tries to use AI to make a optimised shape for the bed support.[like the wierd shaped parts with many triangular cuts that are surprisingly very strong]...
But after half n hour of adjusting all settings like- material, load distribution, solid space, contrains etc FUSION ASKED FOR CLOUD TOKKENS.
LIke, they could have informed me earlier that it would required cloud tokkens.

Finally i choose the manual method.
Started to make a x shape design, and then joined and extruded all the parts.



Right after this design, another idea struck into my mind. instead of making holes for the linear bearings, i can make semicircular cuts to tie them using zip ties..
SO I did that-


...
Well my idea was great but method was horrible..
I first had to take measurements from the assembly file.
then i made a very thin rectangular sketch that would revolve around a axis which lies on the center of the bearing.  Anyways i said, this method was too complicated. i did this on 1 bearing part.
Then i thought, this exact same thing could be done by a semicirclular cut made across the bearing part.


>>>
Finally i added some holes for allowing zip ties to pass through and tie the linear bearing..
Also, i m looking for ways to be able to demonstrate the timing belts in CAD design.

**Total time spent: 1h 30m**

# October 16, 2026 (entry 2): Completed Printer Design
<!-- fabricate:entry 530 -->

finally i added then last part in the printer which is the bed gantry and attached the extruder to the build.



Well i got this extruder model online and i matched the extruder i will be building very likely..
Also, i have decided to keep the printing filament spool seperate from this build as the printer itself is very small and compact.

Anyways, the main CAD is done, so now m moving on to the ELectronics part of the project.

By the way, i rendered the model on a realistic graphic:



**Total time spent: 30m**

# October 18, 2026: Electronics explained & Wiring Diagram
<!-- fabricate:entry 628 -->

not much time time...

I just made a wiring diagram, which will work as the schematic for this project.

MY plan in to not get any pcb and hand wire every component..
Thats way easier...


I have decided to use a raspberry pi pico as the microcontroller for this project. 
It is fast, cheap and supported by marlin. and ofcourse that is way more cooler than arduino mega [arduino mega is outdated board, still used today in diy builds of 3d printer]

for the stepper motor driver, i will be using tmc2225.
I had initially decided to use TMC2209. but this board wasnt shipping anywhere near me by any seller.
So i had to get a lower version tmc2225.
Now, these are WAY WAY better than the a4988 used in most builds..
the a4988 is also an outdated board.

Everything will be powered by a 24v SMPS.
The pico and the stepper motor drivers will get 3.3v, by a DC -DC buck converter.
The hotend will run on 24v.
but there will be a 5A fuse in series with the hotend to limit current if any failure happens.

for the thermistor, i will be using the ntc100k thermistor. its comes along with the hotend,

A IRLZ44N, will be used to control the power to the hotend.

WELL, THATS ALL

**Total time spent: 1h 30m**

# October 19, 2026: Marin Setup
<!-- fabricate:entry 683 -->

Today i made a lot of progress.
First I created a github repo for the project and named my project: FABR [Filament Added Builder & Replicator]
As i had already told, that i will be using Marlin along with raspberry pi pico (rp2040) board for this printer. 
So, I downloaded the MARLIN software from the github repo, then started to work on it. 
IN short, i had to make a custom configuration and files for raspberry pi pico.
_**[I USED CLAUDE AS ASSISTANCE IN CREATING THESE FILES.]**_

First step was to make a custom board file to define the raspberry pi pico to the marlin software.

Next step as to change the configuration files of the marlin to fit my build.
It had things like, no. of axis, board define, endstop switch config, temparature sensor config.
And the most important here was the stepper motor driver.
SINCE i m using TMC2225 for this build but marlin doesnt support TMC2225 natively..
SO i had to make some little twerks to make it work. I selected the TMC2208 instead of the TMC2225 and enabled its standalone mode, so the raspberry pi pico would not try to communicate with the motor driver over UART.
This will fool the pi pico, thinking its a TMC2208 there when is is actually a TMC2225 there.

Finally I create a pin_RASPBERRY_PI_PICO file to define what gpio pins do what on the raspberry pi pico..

Atlast, i clicked BUILD [BTW, i m using VSCode-Platformio to make changes] and it went success.


**Total time spent: 2h**

# October 19, 2026 (entry 2): CAD design electronics case & endstop switch
<!-- fabricate:entry 695 -->

started with designing a electronics case for the project..
NOw this part specifically will be made by carboard, not 3d printed.. i will save cost and will be more convenient.


This was the base design..
The I added some grove on the slide to allow slider-

And also, made the opening on the other side as this side was not accessible.


Then proceeded with making a cover for the box.
The most typical part of this time was to make the cover handle-

i had to go through multiple circle radius and fillet radius before this design was made successfully.


Then i placed all the electronics and added slider motion to the cover lid-


FInally i added all the endstops.




Next part would be to add polishing to the CAD parts.

**Total time spent: 1h 30m**

# October 20, 2026: Completed CAD
<!-- fabricate:entry 720 -->

today i m trying to complete this project.

I started with polishing some part designs, but i couldnt find many parts polish them. 
What i mean is, if would have polished those parts, they would have lost their strength required. For EX: the top and bottom Y axis parts, the moving Z axis part, the moving Y axis part and the rod holders at the base.
SO i did that i could have done to make hem look good..

FIRST, i added a Hack Club logo-


This was on the Z moving part. But this color combination didn't looked right..!!

NOW that looks good..>
Nxt, i made some engraving on the Y axis moving part.


Then i also made some X pattern design on the base plate..

And finally a lightning symbol of the E-closure. [i know this part is supposed to be made from cardboard, but i though i could add the symbol in CAD also]





Finally I added a SMPS to the build to power everything and finally rendered it in RENDER DESIGN-



**Total time spent: 1h 30m**

# October 21, 2026: Completed All Shipping Processes
<!-- fabricate:entry 783 -->

So, after a lot of work, finally.......!!!!!!! i completed all shipping processes..
NOw i m ready to submit this boy..

lets start with some minor cad work ..
Now, i know that i said CAD is over, but i had forgot one minor thing..
There is no idler pulley thing for the bed moving part.

so I FIxed IT.   instead of using any real idler pulley again, i will be using the left over of the smooth rod to make this.



The smooth rod will be inserted in there gap..

But the measurements of this version had flaws so i corrected them and got his finally -



NOW I CAN FINALLY SAY CAD IS OVER..
...........
I also, made a readme for the project and explained, why i made this, how it works, how to make it and explained all software and firmware etc..
It took too long..

[i think it took too long because, this was my first project, where i m using proper markdown language to format readme.md] 

The most time consuming thing i did was SOURCING PARTS !!!!!!!!!
Bro i underestimated this process earlier.. 
Usually when i made projects, i used to source parts along the time when i m designing CAD parts.

But this time i tried to do it after the designing was complete and MAN !!!!  i became nearly exhausted trying to just source all parts..

but i pushed through and completed it.

I also connected the github repo with my computer, so i could easily make changes over time.
it also took time..
I learned some github commands like-
~~~
git clone
~~~

~~~
git pull
~~~
~~~
git push
~~~
~~~
git commit
~~~

ANd finally pushed all files and folders to the repo..

I then also, used a software to calculate volume of each of the part i need to 3d print and total volume comes out to be around 920 cubic cm.
Which translates to around 1.2kg filament..
but since i u not getting 100% infill in any part so 1kg filament will be okay.. i added 1 kg filament in BOM..

**Total time spent: 5h**

# October 22, 2026: Addressing Issues For Design Return
<!-- fabricate:entry 1018 -->

so, my design got returned for some changes and one thing, that i hadnt considered.
I m going to fix them one by one- 

1) Parts aren't holding down to anything-  
this was something that i hadn't noticed. There were parts like Front & Back rod holders, and the top Y-Axis part, that weren't fixed by anything (in the CAD)..

SO i changed it-



I added holes for M4 screw to fit in.
Then i did the same for the other rod holder. 

As for he top Y axis Part, that part doesnt experience any stress, so if i glue that thing with PVA glue to the wooden piece, that wont be a problem.

2) Assembly of the Bed- 
well my plan was not to add a hotbed, to keep the design as low cost and simple as possible.
so, thats why i didnt showed any bed assembly. But now i have done a bed assembly-

first i designed a custom spring in fusion. Then added some screws to the x axis moving gantry.


Next i added the spring to the screws-


NOW, this next part will be made of glass.
This piece will sit on top of that spring loaded base.



and everything secured with a screw-


**_The springs are chipping inside of other parts, because in real build they will be compressed by the glass and base part._**



3) The Twisted Timing Belt of Z axis- 
Well that was on purpose..
you see, by letting the belts twist through the Z axis part, it allows me to keep the orientation of stepper motor and idler pulley at an angle with each other (here its 90 degrees). This make the design very simple.
FOR EX: if i would have kept the stepper motor at 90, from where it is now, the Y AXIS MOVING PART would have to be made way larger, than it is right now..
Also, the twisting of the timing belt doesnt cause any errors, in the printing, as the motor always recieves the belt at the orientation it requires. Changing, this thing, will force me to redo,more of less the whole design.

4) Mounting, the power supply- 
i have already been through this topic in my previous journals..
The electronics case doesnt require any strength to handle thus they will be made out of cardboard.
SO, i will make the mount of PSU, along with electronics case.

Next, i also updated by BOM and the files in the repo.

**Total time spent: 2h**

# October 26, 2026: Addressing Problems
<!-- fabricate:entry 1307 -->

so,my design was again sent back for changes and now this time the reviewer explained it clearly.

there were parts which i was thinking to join via hot melt glue but to make the project polished, i needed to add screws to them..
So, i added screw holes to the top Y axis part


This is for the stepper motor.
And also added screwholes for the vertical support (earlier i thought that friction between the parts was enough to keep them joined)

I also redesinged the hotend part to not use any screw and be part of the 3d printed part as it is..
also, in the cad this part is clipping a bit with the hotend.but that is part of the design, as this will keep the hotend in place in the real build.




Also noticed the changed belt movement system?
yes, i also completely changed the timing belt orientation based on the reviewers feedback..
now the belt moves throughout in the same orientation.

i also increase the length of all Z azis parts to moke the smooth rods apart from 10mm. this was done to make space for the belt hole.

**Total time spent: 2h**

# October 27, 2026: The Y axis Stepper Motor Mount
<!-- fabricate:entry 1309 -->

so, one of the major reason for redesign was the y axis mounted motor.
there was no traditional way i could find to secure the stepper motor as all the components were all very clustered.
but then something struck in my mind and i came up with such a design-


in the groove of the y axis part, there will sit a custom mototr mount part.


this peice has m3 screw holes to secure the motor itself and the part gets secured to the wholey axis assembly via another pair of m3 screws.



the clipping plastice will bend in build and push the motor away from itself, which will lock the mount even further via friction

**Total time spent: 1h 30m**

# October 28, 2026: Reviewers Feedback
<!-- fabricate:entry 1471 -->

so again my project was sent back for changes due to same reason of support and screws.

First reason was that the vertical support wooden block wasn't extending into the top y axis part.
So i fixed that part.

next added screw holes for the extruder motoor. initially i though that it wasnt needed as that part sits on the wooden piece so it must have been obvious that it will be screws it but then in the feedback, reviewer said that i must add screw holes to make the project polished.



Also added screw holes in the bottom Y axis part.
the reviewer also mentioned that aligning the bottom y axis part will be difficult so i modifies the bottom y axis part a bit so that its alignment will be easier.


Next the PSU..
I was reluctant to make this make as i had to build this with carboard along with the electronics board.
But now i have no choice.-

made such a bracket for the PSU.


**Total time spent: 2h**
