KingsStarDV/FABR/(commit log)

2026-10-19 Document 3D printer design and development process
    Added detailed journal entries documenting the design and development process of a 3D printer, including CAD modeling, electronics setup, and Marlin configuration.
2026-10-20 Update README with Marlin and Pronterface instructions
    Added instructions for Marlin firmware and Pronterface setup.
2026-10-20 Revise Marlin software download instructions
    Updated instructions for downloading Marlin software and clarified setup options.
2026-10-20 Correct file format from 'stp' to 'stl' in README
2026-10-21 added new bom
2026-10-21 new assembly and front part
2026-10-21 Revise JOURNAL.md with project updates
    Updated the JOURNAL.md file with detailed entries about the 3D printer project, including design changes, CAD modeling, electronics setup, and sourcing parts.
2026-10-21 Add Bill of Materials to README
    Added a Bill of Materials section with item details and links.
2026-10-21 filament added in BOM
2026-10-26 Revise JOURNAL.md with detailed project updates
    Updated journal entries detailing the design and development of the FABR 3D printer, including CAD modeling, electronics setup, and addressing design issues.
2026-10-28 Update README with new image and cost correction
    Added an image for Assembly Render and updated the total cost in the README.
2026-10-28 added timing pulley
